Genzkidgrownup/Flipper/BOM.csv

Item | Qty | Supplier | Cost/item | Total Cost | link
ATtiny85 | 1 | quartzcomponents | $2.45 | $2.45 | https://quartzcomponents.com/products/attiny85-8-bit-avr-microcontroller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
SPDT slide switch | 4 | robu | $0.03 | $0.12 | https://robu.in/product/1-month-warranty-691/
Polarized capacitor 100microferrate | 5 | Robu | $0.03 | $0.15 | https://robu.in/product/100-uf-35v-through-hole-electrolytic-capacitor-dip-pack-of-10/?gad_source=1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
100nF 0805 Surface Mount Multilayer Ceramic Capacitor | 20 | Robu | $0.01 | $0.20 | https://robu.in/product/100nf-0805-surface-mount-multilayer-ceramic-capacitor-pack-of-40/
10K Ohm 1/8W 805 Resistor | 40 | Robu | $0.01 | $0.40 | https://robu.in/product/10k-ohm-1-8w-805-resistorreel-of-5000/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
Magnets | 1 | Flipkart | $2.50 | $2.50 | https://www.flipkart.com/magneticks-200-pcs-3x2mm-steel-magnets-nickle-plated-n45-grade-fridge-magnet-pack/p/itm792e5ca2eaeab
EasyMech M3x40mm CHHD Bolt and Nut Set | 2 | robu | $0.82 | $1.64 | https://robu.in/product/m315mm-nylon-screw-50-pcs/
1x40 Pin 2.54MM Berg Strip Male connector | 2 | robu | $0.06 | $0.12 | https://robu.in/product/1x40-berg-strip-male-connector/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
FEMALE headers | 1 | Robu | $0.40 | $0.40 | https://robu.in/product/2mm-pitch-female-berg-strip-40x1-2pcs/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
MT3608 | 1 | Robu | $0.41 | $0.41 | https://robu.in/product/mt3608-2a-max-dc-dc-step-up-power-module-booster-power-module/?gad_source=1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
3.7V lipo Battery | 2 | Amazon | $2.08 | $4.16 | https://www.amazon.in/gp/product/B0HC6RRYJL/ref=ox_sc_act_title_1?smid=A2J0MMX5A7G1FN&psc=1
Metal french barrette | 1 | Flipkart | $1.26 | $1.26 | https://www.flipkart.com/zft-metal-french-barrette-hair-clip-long-platinum-diy-accessories-accessory-set/p/itm5b7884b281e0a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
Estimated total shipping | 1 |  |  | $5.00
