Genzkidgrownup/Flipper/3D file/Editable files(.step and .f3z)/FlipperLOL.step

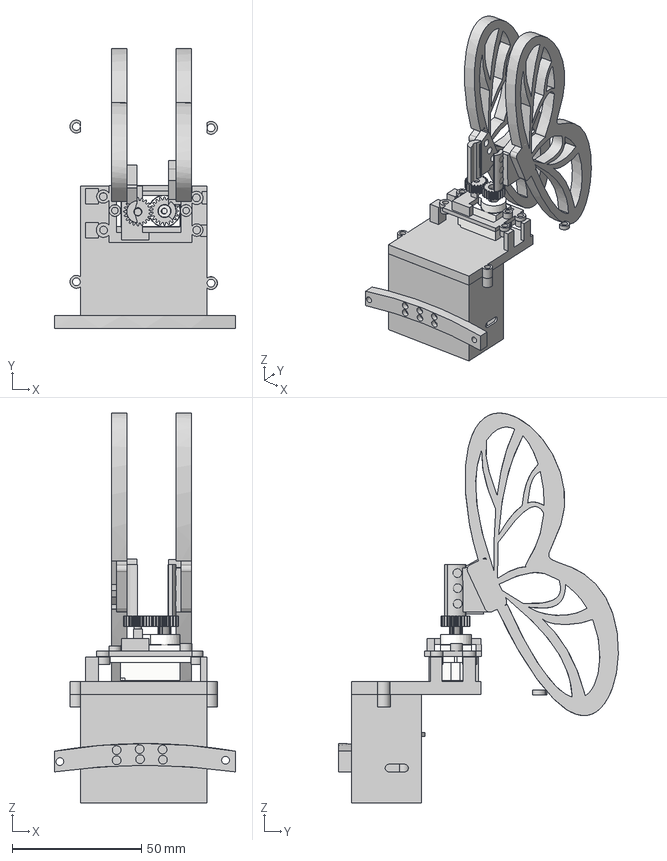
[picture p1: CAD file, 2026-10-24]
3D file/Editable files(.step and .f3z)/FlipperLOL.step
70.0 x 108.1 x 150.7 mm
