Genzkidgrownup/Flipper/3D file/PCB 3D file (if needed)/3D_Flipperfinal_2026-10-25.step

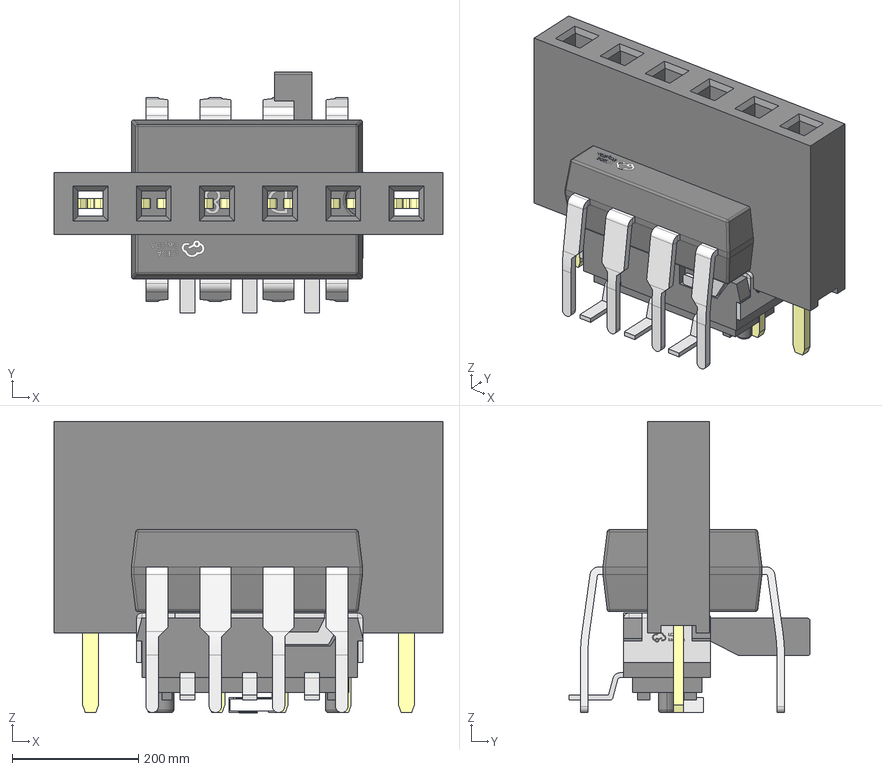
[picture p2: CAD file, 2026-10-24]
3D file/PCB 3D file (if needed)/3D_Flipperfinal_2026-10-25.step
615.7 x 381.9 x 460.7 mm
Board~G4bW
TopCopper~G4bW
BottomCopper~G4bW
TopSilkscreen~G4bW
BottomSilkscreen~G4bW
TopFpcStiffener~G4bW
BottomFpcStiffener~G4bW
R0805~R0805~bTyR
SW-SMD_MST-12D18G4-SPDT-SLIDE-SWITCH~SW-SMD_MST-12D18G4-SPDT-SLIDE-SWITCH~X3FL
PDIP-8_L9.3-W6.4-P2.54-LS7.9-BL-1~PDIP-8_L9.3-W6.4-P2.54-LS7.9-BL-1~Apl4
HDR-TH_PM2.54-1X6PZZ-H8.5~HDR-TH_PM2.54-1X6PZZ-H8.5~YFyl
