Genzkidgrownup/Flipper/3D file/Printable parts/Spur Gear 20 teeth.stl

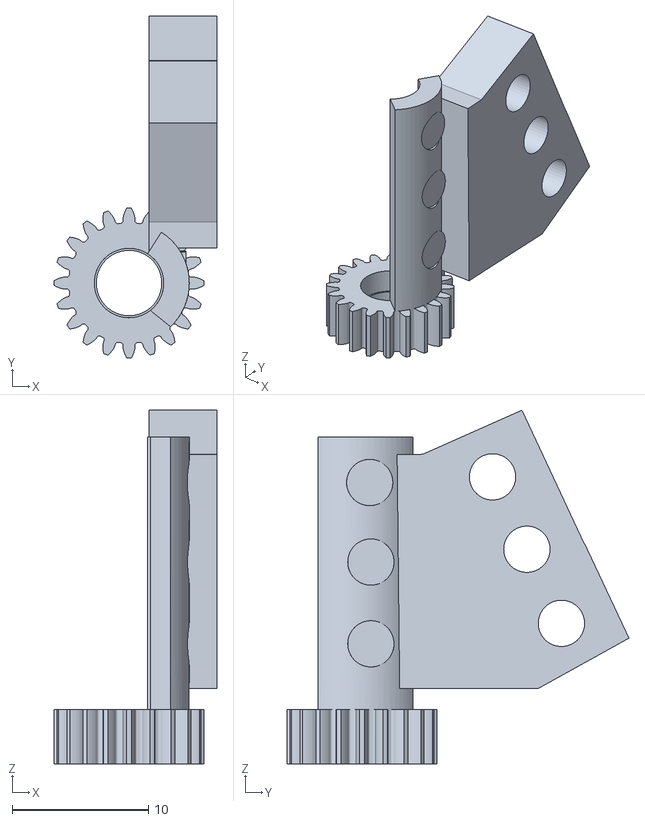
[picture p3: CAD file, 2026-10-21]
3D file/Printable parts/Spur Gear 20 teeth.stl
12.0 x 25.1 x 26.0
