Genzkidgrownup/Flipper/3D file/Printable parts/middle lid.stl

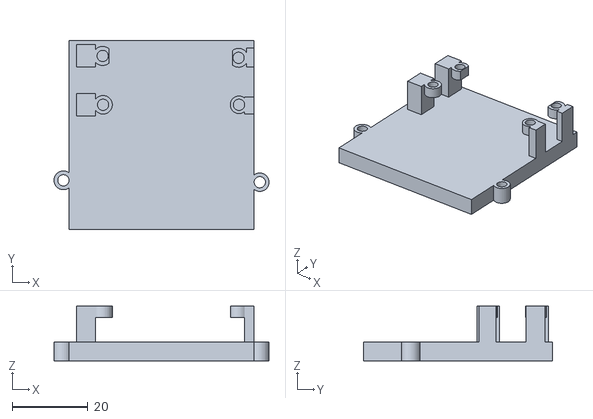
[picture p4: CAD file, 2026-10-18]
3D file/Printable parts/middle lid.stl
56.9 x 50.0 x 14.5
