Genzkidgrownup/Flipper/3D file/Printable parts/upperlid.stl

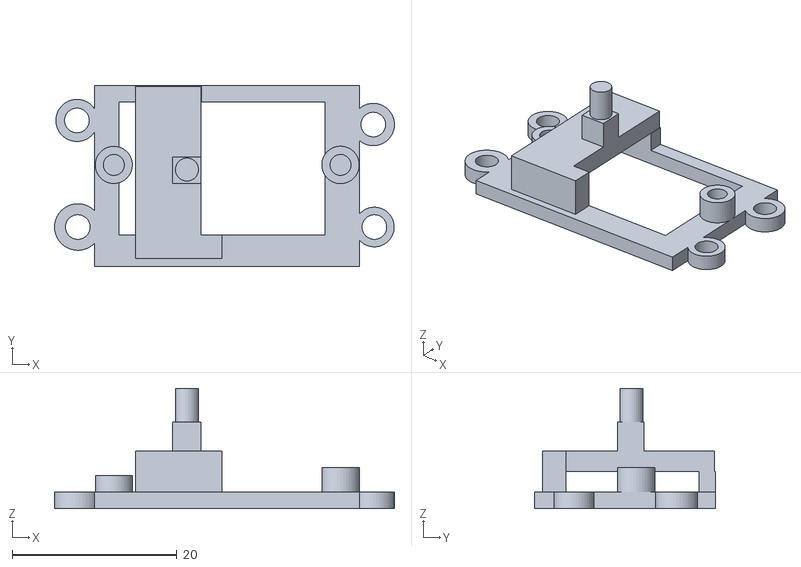
[picture p5: CAD file, 2026-10-18]
3D file/Printable parts/upperlid.stl
41.3 x 22.0 x 14.6
