Genzkidgrownup/Flipper/3D file/Printable parts/bottomlid.stl

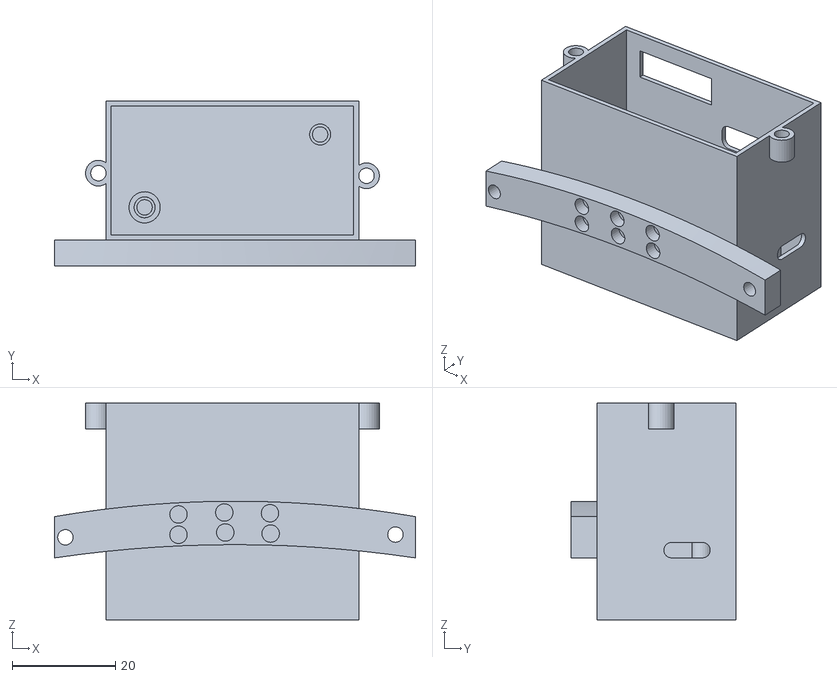
[picture p6: CAD file, 2026-10-18]
3D file/Printable parts/bottomlid.stl
70.0 x 32.0 x 42.0
