Genzkidgrownup/Flipper/3D file/Printable parts/wing_1.stl

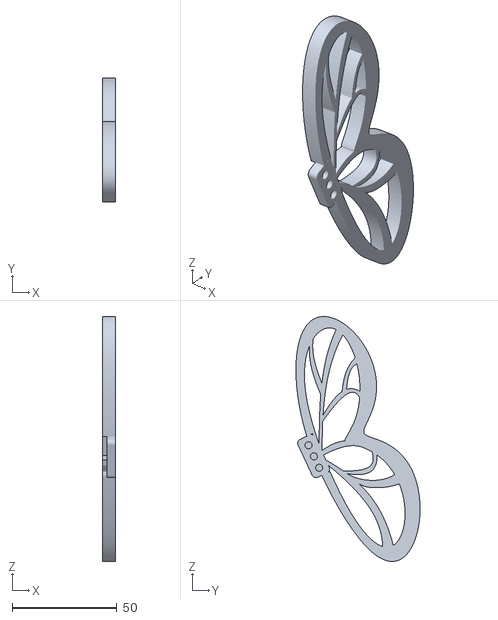
[picture p7: CAD file, 2026-10-18]
3D file/Printable parts/wing_1.stl
6.00 x 59.3 x 116.9
