Genzkidgrownup/Flipper/3D file/Printable parts/Spur Gear 20 teeth (1).stl

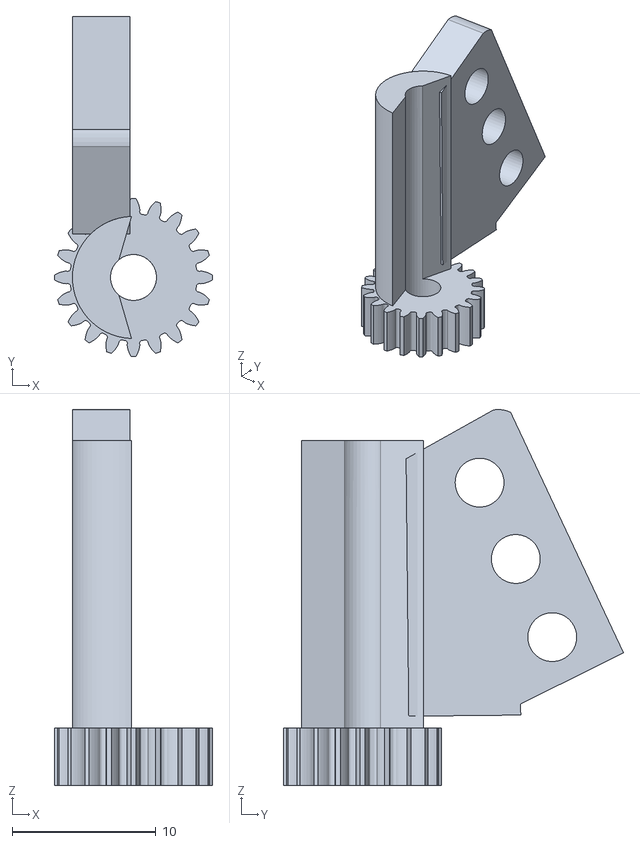
[picture p8: CAD file, 2026-10-21, an earlier design]
3D file/Printable parts/Spur Gear 20 teeth (1).stl
11.0 x 23.7 x 26.2
