Genzkidgrownup/Flipper/(list of files, cad)

Other CAD files:
3D file/Printable parts/wing_2.stl
3D file/Editable files(.step and .f3z)/flipperrr editable file.f3z
