Genzkidgrownup/Flipper/JOURNAL.md

# Flipper – devlog

<!-- Generated by Half Life from project cmv4us1ss0fzo01n0bod3zwk1. Edits here are overwritten on the next sync. -->
<!-- Generated: 2026-10-18T11:36:06.730Z -->

> [!NOTE]
> This devlog is mirrored from [Half Life](https://halflife.hackclub.com) – [open the project](https://halflife.hackclub.com/projects/cmv4us1ss0fzo01n0bod3zwk1). Editing it here will not change the platform's copy, and the next sync overwrites this file.

> In this week i am going to make a custom  mechanical girls clutcher or hair clip i  am going to design which will move along an axis just as an butterfly wings

| Week | Tier | Hours logged | Entries |
| --- | --- | --- | --- |
| Week 2 | Tier 1 | 22.78h | 17 |

## Contents

1. [2026-10-12 – In this session  for Week 2 project i started with making the PCB although the theme is 3D file designing but without a PCB i cant start designing the 3D file for my flipper claw clip](#2026-10-12-in-this-session-for-week-2-project-i-started-with)
2. [2026-10-12 – Here i made the PCB outline and routed the board and put ground copper plates to reduce Electrical noise](#2026-10-12-here-i-made-the-pcb-outline-and-routed-the-board-)
3. [2026-10-13 – ](#2026-10-13-screenshot-2026-10-13-113758httpshalflifehackclub)
4. [2026-10-13 – HI hackclub official or anyone else in this session ,](#2026-10-13-hi-hackclub-official-or-anyone-else-in-this-sessi)
5. [2026-10-13 – Hi Hack club officials or reviewers or someone else](#2026-10-13-hi-hack-club-officials-or-reviewers-or-someone-el)
6. [2026-10-14 – HIEEEE Hacklub HERE i spotted a major problem that is PB3 pin cant transmit analogwrite() or PWM signals and for servo i required PWM signals .So i switched to PB4 which was also a free pin which tran](#2026-10-14-hieeee-hacklub-here-i-spotted-a-major-problem-tha)
7. [2026-10-14 – Here in this session , I spotted a bug in my PCB that was the decoupling capacitor for ATtiny85 was actually close to its GND pin but far from the VCC pin , so i re positioned some components and adde](#2026-10-14-here-in-this-session-i-spotted-a-bug-in-my-pcb-th)
8. [2026-10-14 – Here in this session i was working then i realized this , that my lapse wasn't working or glitched out , almost 45 minutes of my work wasn't recorded by i am proceeding with 30 mins so 0.5hr i am jour](#2026-10-14-here-in-this-session-i-was-working-then-i-realize)
9. [2026-10-15 – Here in this session , i was building the top lid of the enclosure to make it fit with the bottom lid and also made the standoff screw mounting holes so i can fit it and adjusted the TP4056 charging m](#2026-10-15-here-in-this-session-i-was-building-the-top-lid-o)
10. [2026-10-15 – So Hackclub officials or reviewers , My lapse again was not working for 30mins ..in the session i was](#2026-10-15-so-hackclub-officials-or-reviewers-my-lapse-again)
11. [2026-10-15 – ](#2026-10-15-screenshot-2026-10-15-172729httpshalflifehackclub)
12. [2026-10-15 – Hi hackclubers or reviewers,](#2026-10-15-hi-hackclubers-or-reviewers)
13. [2026-10-17 – Here in this session , I made the butterfly wings .When i first drew the sketch and extruded it completely looked bad and wasn't looking like a butterfly wings.](#2026-10-17-here-in-this-session-i-made-the-butterfly-wings-w)
14. [2026-10-17 – ](#2026-10-17-screenshot-2026-10-17-144210httpshalflifehackclub)
15. [2026-10-17 – Hi hackclub officials or reviewers ,](#2026-10-17-hi-hackclub-officials-or-reviewers)
16. [2026-10-17 – Hi hackclub members or reviewers , Here i added the 70cm metal barrette standoff holes and magnetic holes to hold the full structure and i searched the internet for the metal barrette simulated the co](#2026-10-17-hi-hackclub-members-or-reviewers-here-i-added-the)
17. [2026-10-18 – Here i made my github repo for flipper , changed the readme.md , changed some glitches in PCB ( basically the PAD position was colliding with SMD capacitor so i repositioned it )  and made my BOM , ma](#2026-10-18-here-i-made-my-github-repo-for-flipper-changed-th)

## Design

### 2026-10-12 – In this session  for Week 2 project i started with making the PCB although the theme is 3D file designing but without a PCB i cant start designing the 3D file for my flipper claw clip

**1.48h**

In this session  for Week 2 project i started with making the PCB although the theme is 3D file designing but without a PCB i cant start designing the 3D file for my flipper claw clip
I started with listing out what exactly I need and checked the connections with simulation ,
and then started drawing my schematic and
i faced one of the problems that is
I need a boost converter whose footprints are not available in EasyEDA
so i downloaded the footprint and symbol for it and imported it in my schematic
and drew the board outline as small as possible
i will start the routing from next session





[Timelapse](https://lookout.hackclub.com/api/media/43030c9b-3c1e-48ab-874e-4655e4b04c56/video.mp4)

### 2026-10-12 – Here i made the PCB outline and routed the board and put ground copper plates to reduce Electrical noise

**1.33h**

Here i made the PCB outline and routed the board and put ground copper plates to reduce Electrical noise
i tried a custom outline for PCB but it was too small , so i made another outline which is as small as possible





[Timelapse](https://lookout.hackclub.com/api/media/52ed264a-253d-4e70-97ab-de3afd013119/video.mp4)

[Timelapse](https://lookout.hackclub.com/api/media/6363f3a3-3fe2-4202-bb74-1b0f9f48ce40/video.mp4)

### 2026-10-13 – 

**1.5h**













Hi hackclub members or officials , Here i finalized my design for PCB of flipper and i made as small as possible to make it fit in the CAD as its a hairpin for girls and my goal is to make them feel comfortable and also fashionable
I reduced all the electrical noises by putting ground copper plates on both the layers
made one symbol and footprint of my own of MT3608 to make the 3.7V battery give output of 5V so the MG90s servo gets powered with arduino nano running on it .

[Timelapse](https://lookout.hackclub.com/api/media/5a9c3070-9e7e-4a90-9f7a-73ac55d9f7e0/video.mp4)

### 2026-10-13 – HI hackclub official or anyone else in this session ,

**1.5h**

HI hackclub official or anyone else in this session ,
I started off by making the enclosure and wings  of flipper
First,
I imported my PCB (.step ) file into my fusion 360 software
where i made mi file for flipper , i did it through the online tool of EasyEDA pro and then as i need servo motor(MG90s) specifically for the movements of wing so i imported that CAD file too from grabCAD where i installed the CAD file and imported the upper body , lower body and the Main screw
Then i assembled it and made it as a rigid body .
Just in the base of my imported PCB i made an enclosure sketch which i will extrude on next session with mounting screws

Here are the screenshots:-







[Timelapse](https://lookout.hackclub.com/api/media/023ad028-6057-49a8-b1db-cc64117329e6/video.mp4)

### 2026-10-13 – Hi Hack club officials or reviewers or someone else

**3.17h**

Hi Hack club officials or reviewers or someone else
In this session, my whole Project's layout got changed
When i was going to make the Enclosure of my flipper with the butterfly wings
I noticed something which can be done way better and cheaper , yes but I knew it would hard for me
As i am a beginner , but i love to grow my skills and learn something new Everyday.
I did not hesitate and took the challenge
Seriously after sometime designing the CAD , i realized that Arduino Nano is an Over-kill for a simple Servo moved wings , i shifted to ATtiny85 , it was my first time designing with an IC
I got guide from the Huddle too and it really helped me out
I finished y schematic and Routed the whole board with copper traces and made the board only(38x18)mm making it perfect for girls to be comfortable with an hairclip too
And the best thing in this session is
that I over come my fear and learned something new
and that's the "Best feeling" after all













[Timelapse](https://lookout.hackclub.com/api/media/d982ff72-88ec-46cc-92e2-671a1e7d2ab4/video.mp4)

### 2026-10-14 – HIEEEE Hacklub HERE i spotted a major problem that is PB3 pin cant transmit analogwrite() or PWM signals and for servo i required PWM signals .So i switched to PB4 which was also a free pin which tran

**1.18h**

HIEEEE Hacklub HERE i spotted a major problem that is PB3 pin cant transmit analogwrite() or PWM signals and for servo i required PWM signals .So i switched to PB4 which was also a free pin which transmits PWM signals so i used it for my Servo
Then poured copper ground plates which will reduce Electrical noise from the MT3608 and the ATtiny85 IC
Did detailed silkscreen Art (adding my product's name , my name , my future company's name ) and added some butterflies





[Timelapse](https://lookout.hackclub.com/api/media/354c2fbb-683c-4ac0-97f6-bf7e578a56f7/video.mp4)

### 2026-10-14 – Here in this session , I spotted a bug in my PCB that was the decoupling capacitor for ATtiny85 was actually close to its GND pin but far from the VCC pin , so i re positioned some components and adde

**0.87h**

Here in this session , I spotted a bug in my PCB that was the decoupling capacitor for ATtiny85 was actually close to its GND pin but far from the VCC pin , so i re positioned some components and added the copper traces , then i exported the .step file into my fusion Flipper_V2  then i imported the MG90s .step file and assembled it and made the base sketch and extruded it







[Timelapse](https://lookout.hackclub.com/api/media/a7020674-3850-4e5c-81d7-843174d00c9c/video.mp4)

### 2026-10-14 – Here in this session i was working then i realized this , that my lapse wasn't working or glitched out , almost 45 minutes of my work wasn't recorded by i am proceeding with 30 mins so 0.5hr i am jour

**0.83h**

Here in this session i was working then i realized this , that my lapse wasn't working or glitched out , almost 45 minutes of my work wasn't recorded by i am proceeding with 30 mins so 0.5hr i am journaling ,
when lapse glitched out:
 in that 30 mins i made the switch hole checked the inner part of the extrude has some space or not and added TP4056 charging module hole , saw that MT3608 will fit in the back side or not after measuring all this i decided to make the box height 40mm.



When Lapse was on:
I was designing the CAD file for my flipper . Here i started of by making the base extruded it and made the screw mounting holes



[Timelapse](https://lookout.hackclub.com/api/media/75bedc94-f560-4d1f-9b5c-f9ebd35827cf/video.mp4)

### 2026-10-15 – Here in this session , i was building the top lid of the enclosure to make it fit with the bottom lid and also made the standoff screw mounting holes so i can fit it and adjusted the TP4056 charging m

**1.13h**

Here in this session , i was building the top lid of the enclosure to make it fit with the bottom lid and also made the standoff screw mounting holes so i can fit it and adjusted the TP4056 charging module place





[Timelapse](https://lookout.hackclub.com/api/media/7e5052ed-caf7-4d77-afa1-9ca6093a75c8/video.mp4)

### 2026-10-15 – So Hackclub officials or reviewers , My lapse again was not working for 30mins ..in the session i was

**0.5h**

So Hackclub officials or reviewers , My lapse again was not working for 30mins ..in the session i was
I will be journaling that session in the next journal
I made this journal entry specifically to add up this 30 minutes





### 2026-10-15 – 

**2.33h**

























In the first 15mins i noticed a bug that was when i opened the .stl file of bottom lid , it came with the PCB and PCB components and the servo file with Servo shafts , so i deleted the base and top lid , and made it once again , Then i pulled off the hardest Part to make the gear system where the wings will flap
I made 3mm x2mm holes in the gear extrusion to put small magnets there and attach the wings without any standoff screws or support as 3D printed parts will be light weight the magnets can pull it off . In the next session i will be making the wings.

[Timelapse](https://lookout.hackclub.com/api/media/357c95f3-4345-4e69-b0f6-e7a04d789212/video.mp4)

### 2026-10-15 – Hi hackclubers or reviewers,

**0.35h**

Hi hackclubers or reviewers,
In this session ,
here i made my PCB better and tried to design the wings but i felt , well in INDIA right now its 3 a.m so i gotta sleep , tomorrow morning i will be starting to design the Wings





[Timelapse](https://lookout.hackclub.com/api/media/78f6fc78-3ac6-4f68-821f-b608b8595f78/video.mp4)

### 2026-10-17 – Here in this session , I made the butterfly wings .When i first drew the sketch and extruded it completely looked bad and wasn't looking like a butterfly wings.

**1.93h**

Here in this session , I made the butterfly wings .When i first drew the sketch and extruded it completely looked bad and wasn't looking like a butterfly wings.
SO in the second try
I made one part of the wing , extruded it and checked whether it looked good or not ?
If it did i moved to the next part
If it didn't i edited the part i made
And thats how i made the wings





[Timelapse](https://lookout.hackclub.com/api/media/45ad04f5-d8fe-4f95-997a-62e866be08bf/video.mp4)

### 2026-10-17 – 

**0.5h**





Hi hackclub officials or reviewers i faced the same problem where my lapse didn't got recorded it some parts while watching the previous journal's lapse you could understand that some parts gone cut , thats when the lapse app failed to record for my network isuse Iguess ,It would have been better if the outlook app ran offline.

### 2026-10-17 – Hi hackclub officials or reviewers ,

**1.68h**

Hi hackclub officials or reviewers ,
Here i designed the wings of the flipper
FIRST i followed a photo in pinterest
but it didn't worked out so i tried to design own my own by extruding each part one by one and confirming it.
and then a extruded the middle lid and i added standoff screws , i changed the MG90s standoff shell  so the wings can rotate easily without much oscillation so that it looks Smooth.











[Timelapse](https://lookout.hackclub.com/api/media/f5bc1a69-bd2d-4434-aff8-e762c9b5854b/video.mp4)

[Timelapse](https://lookout.hackclub.com/api/media/cf56cfd5-aa8b-48bb-90e4-9ef4744dd4b2/video.mp4)

### 2026-10-17 – Hi hackclub members or reviewers , Here i added the 70cm metal barrette standoff holes and magnetic holes to hold the full structure and i searched the internet for the metal barrette simulated the co

**0.42h**

Hi hackclub members or reviewers , Here i added the 70cm metal barrette standoff holes and magnetic holes to hold the full structure and i searched the internet for the metal barrette simulated the code to run the MG90s motor





[Timelapse](https://lookout.hackclub.com/api/media/222cad2a-03a5-44e7-b727-2a7bad866e56/video.mp4)

### 2026-10-18 – Here i made my github repo for flipper , changed the readme.md , changed some glitches in PCB ( basically the PAD position was colliding with SMD capacitor so i repositioned it )  and made my BOM , ma

**2.08h**

Here i made my github repo for flipper , changed the readme.md , changed some glitches in PCB ( basically the PAD position was colliding with SMD capacitor so i repositioned it )  and made my BOM , made my closing reel





[Timelapse](https://lookout.hackclub.com/api/media/f117e421-6856-4e15-86a8-043f9f9f7f60/video.mp4)
