Genzkidgrownup/Flipper/(commit log)

2026-10-15 Sync Flipper from Half Life
    [BOM.csv]
2026-10-18 Enhance README with project details and instructions
    Added detailed project overview, hardware specifications, wiring diagrams, and assembly instructions.
2026-10-18 Update SMD decoupling capacitor details in README
2026-10-18 Rename Flipper.f3z to 3D file/Flipper.f3z
    [Flipper.f3z]
2026-10-18 Rename 3D file/wing_2.stl to 3D file/Printable parts/wing_2.stl
    [wing_2.stl]
2026-10-18 Rename PCB_Trial-flipperV2_2026-10-18.pcbdoc to Easy EDA/PCB_Trial-flipperV2_2026-10-18.pcbdoc
    [PCB_Trial-flipperV2_2026-10-18.pcbdoc]
2026-10-18 Add basic servo control to Version1.ino
2026-10-19 Rename 3D file/3D_PCB_Trial-flipperV2_2026-10-20_yoyoi_2026-10-20.step to 3D file/PCB step file(if needed)/3D_PCB_Trial-flipperV2_2026-10-20_yoyoi_2026-10-20.step
    [3D_PCB_Trial-flipperV2_2026-10-20_yoyoi_2026-10-20.step]
2026-10-19 Rename 3D file/Flipper_final.step to 3D file/Enclousre step file/Flipper_final.step
    [Flipper_final.step]
2026-10-19 Add BOM section to README with item details
    Added a Bill of Materials (BOM) section with item details, quantities, suppliers, costs, and links.
2026-10-21 Add Flipper_final.step to editable files directory
    [Flipper_final.step]
2026-10-21 Update assembly instructions in README
    Added instructions for 3D part assembly and battery connection.
2026-10-24 Rename 3D_Flipperfinal_2026-10-25.step to PCB 3D file (if needed)3D_Flipperfinal_2026-10-25.step
    [3D_Flipperfinal_2026-10-25.step, PCB 3D file (if needed)3D_Flipperfinal_2026-10-25.step]
2026-10-24 Rename 3D file/PCB 3D file (if needed)3D_Flipperfinal_2026-10-25.step to 3D file/PCB 3D file (if needed)/3D_Flipperfinal_2026-10-25.step
    [3D_Flipperfinal_2026-10-25.step]
2026-11-08 Update link for SPDT slide switch in BOM.csv
    [BOM.csv]
2026-11-08 Fix link for PDT slide switch supplier
    Updated the link for the PDT slide switch supplier.
